vietanh198/DesignPrecisioScale1kg/LINK VIDEO SẢN PHẨM.pdf

## LINK VIDEO SẢN PHẨM:

https://drive.google.com/file/d/1iEhDTJ08PTPSHA_bE4boK7S-m8LxpTM4/view?usp=sharing
