vietanh198/DesignPrecisioScale1kg/(list of files, drawings)

Other design files:
ProteusSimulation/Test.pdsprj
