vietanh198/DesignPrecisioScale1kg/STM CODE/SCALE/Core/Src/main.c

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
/* Includes ------------------------------------------------------------------*/
#include "main.h"


void SystemClock_Config(void);
static void MX_GPIO_Init(void);
/* USER CODE BEGIN 0 */
int16_t max_value;
double kp = 2140;
double read1=0, offset=0;
double gram=0;

uint32_t readCount(){
	uint32_t data;
	uint8_t j;
	HAL_GPIO_WritePin(DOUT_GPIO_Port, DOUT_Pin,1);
	HAL_GPIO_WritePin(SCK_GPIO_Port,SCK_Pin,0);
	data=0;
	while(HAL_GPIO_ReadPin(DOUT_GPIO_Port,DOUT_Pin));
	for(j=0;j<24;j++){
		HAL_GPIO_WritePin(SCK_GPIO_Port,SCK_Pin,1);
		data=data<<1;
		HAL_GPIO_WritePin(SCK_GPIO_Port,SCK_Pin,0);
		if(HAL_GPIO_ReadPin(DOUT_GPIO_Port,DOUT_Pin)){
			data++;
		}
	}
		HAL_GPIO_WritePin(SCK_GPIO_Port,SCK_Pin,1);
		data=data^0x800000;
		HAL_GPIO_WritePin(SCK_GPIO_Port,SCK_Pin,0);
		return data;
}

double readAverage(){
	double sum=0;
	for(int k=0;k<20;k++){
		sum+= readCount();
	}
	sum/=20;
	return sum;
}

void HAL_GPIO_EXTI_Callback(uint16_t GPIO_Pin){
	if(GPIO_Pin == UP_Pin){
		uint32_t time=HAL_GetTick();
		while(HAL_GPIO_ReadPin(GPIOB, GPIO_PIN_15)==0){
				if(HAL_GetTick()-time>=200){
				max_value +=5;
				time=HAL_GetTick();
				}
				lcd16x2_setCursor(1,1);
				lcd16x2_printf("max: %4d", max_value);
			  
		}
	}
	else if(GPIO_Pin == DOWN_Pin){
		uint32_t time=HAL_GetTick();
		while(HAL_GPIO_ReadPin(GPIOB, GPIO_PIN_14)==0){
			if(HAL_GetTick()-time >=200){
				max_value -=5;
				time=HAL_GetTick();
			}
			if(max_value<0) max_value=0;
			lcd16x2_setCursor(1,1  );
			lcd16x2_printf("max: %4d", max_value);
		}
	}
	else if(GPIO_Pin==ZERO_Pin){
		offset=readAverage();
	}
}
/* USER CODE END 0 */

/**
  * @brief  The application entry point.
  * @retval int
  */
int main(void)
{
  /* MCU Configuration--------------------------------------------------------*/

  /* Reset of all peripherals, Initializes the Flash interface and the Systick. */
  HAL_Init();

  /* Configure the system clock */
  SystemClock_Config();

  /* Initialize all configured peripherals */
  MX_GPIO_Init();
  /* USER CODE BEGIN 2 */
	lcd16x2_init_4bits(GPIOB, GPIO_PIN_0, GPIO_PIN_1, GPIOA, GPIO_PIN_4, GPIO_PIN_5, GPIO_PIN_6, GPIO_PIN_7); 
	offset =readAverage();

  /* USER CODE END 2 */

  /* Infinite loop */
  /* USER CODE BEGIN WHILE */
  while (1)
  {
		read1= readAverage();
		if (offset >= read1) {
      double val1 = (offset - read1);
      gram = val1;
    } 
    else {
      double val2 = (read1 - offset);
      gram = val2;
    }
		lcd16x2_setCursor(0,1);
		lcd16x2_printf("m: %9.4f ", gram/kp );
		lcd16x2_setCursor(1,1);
		lcd16x2_printf("max: %4d", max_value);
		float weight=gram/kp;
		if(weight-max_value>0) HAL_GPIO_WritePin(LED_GPIO_Port,LED_Pin,1);
		else HAL_GPIO_WritePin(LED_GPIO_Port,LED_Pin,0);
		HAL_Delay(100);

    /* USER CODE END WHILE */

    /* USER CODE BEGIN 3 */
  }
  /* USER CODE END 3 */
}

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
