vietanh198/DesignPrecisioScale1kg/STM CODE/SCALE/Core/Inc/main.h

#define DOUT_Pin GPIO_PIN_0
#define DOUT_GPIO_Port GPIOA
#define SCK_Pin GPIO_PIN_1
#define SCK_GPIO_Port GPIOA
#define LED_Pin GPIO_PIN_2
#define LED_GPIO_Port GPIOA
#define ZERO_Pin GPIO_PIN_13
#define ZERO_GPIO_Port GPIOB
#define ZERO_EXTI_IRQn EXTI15_10_IRQn
#define DOWN_Pin GPIO_PIN_14
#define DOWN_GPIO_Port GPIOB
#define DOWN_EXTI_IRQn EXTI15_10_IRQn
#define UP_Pin GPIO_PIN_15
#define UP_GPIO_Port GPIOB
#define UP_EXTI_IRQn EXTI15_10_IRQn
