vietanh198/DesignPrecisioScale1kg/(notices)

Notices in the files:
STM CODE/SCALE/Core/Src/main.c:
© Copyright (c) 2021 STMicroelectronics.
All rights reserved.
This software component is licensed by ST under BSD 3-Clause license,
the "License"; You may not use this file except in compliance with the
License. You may obtain a copy of the License at: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
STM CODE/SCALE/Core/Inc/main.h:
(C) COPYRIGHT STMicroelectronics *****END OF FILE
